ProjetMajeurEse5ETI/Hardware/Alimentation/Documents/TD-Projet-Majeure-Alimentation-36V-vers-5V-Correction.pptx

## Projet majeure – TP Alimentation

September 2024
Matisse BOFFY – Analog Field Applications Engineer
+33 6 86 36 88 47 | m-boffy@ti.com

## Specifications

Maximum Input Voltage | 36V
Nominal Input Voltage | 30V
Output Voltage | 5V
Output Current | 2.5A
Target Efficiency | 92%
Output voltage ripple | < 5%
Output voltage variation during 50% to 100% load steps | < 5%
Switching frequency | 200kHz
Maximum inductor current ripple | 30%

Specifications du projet

Bonnes pratiques

## Power Stage – P-MOS selection criteria

- Key specifications
  - Drain-source breakdown voltage V_(DS)
  - Continuous Drain Current I_D
  - Drain−source ON resistance R_(DS_(on))
  - Total gate charge Q_G
  - Output capacitance C_(oss)
- Losses : Conduction, switching & gate drive
  - P_(cond) =I_(RMS) ^2 ×R_(DS_(on))
  - P_(sw) =(F_(sw))/2(V_(IN) ×I_(pk) ×t_(swON) )+(F_(sw))/2(V_(IN) ×I_(pk) ×t_(swOFF) )
  - P_(Gdrive) =V_G ×F_(SW) ×Q_G

Notes: Output cap Coss effect

## Power Stage – P-MOS selection

- OnSemi FDC5614P
- Key specifications
  - Drain−source ON resistance R_(DS_(on)) : 105 mΩ (@V_(GS) =−10V)
  - Drain-source breakdown voltage V_(DS) : -60V
  - Continuous Drain Current I_D : -3A @25°C
  - Total gate charge Q_G : 24 nC
  - Output capacitance C_(oss) : 90 pF
- Losses : Conduction, switching & gate drive
  - P_(cond) =I_(RMS) ^2 ×R_(DS_(on)) =(1/(√2))^2 ×0.078= 0.8 mW
  - P_(sw) =(F_(sw))/2(V_(IN) ×I_(pk) ×t_(swON) )+(F_(sw))/2(V_(IN) ×I_(pk) ×t_(swOFF) ) = 220 mW
  - P_(Gdrive) =V_G ×F_(SW) ×Q_G = 7.6 mW
  - Total Power losses P_(totMOS) =228.4 mW

Notes: Output cap Coss effect

## Power Stage – Inductor selection criteria

- Key specifications
  - Inductance value
  - Saturation current 10% I_(SAT)
  - RMS current I_(RMS) (20, 40°C)
  - Equivalent Series Resistor ESR
- Losses : Conduction, core & windings
  - P_(cond) =I_(LRMS) ^2 ×ESR
  - Cores & windings losses are specified in manufacturer’s datasheet

Notes: Output cap Coss effect

## Power Stage – Inductor selection

- Coiltronics DR127-330
- Key specifications
  - Inductance value with 30% current ripple at 30Vin:
L=(V_(out) ×(V_(in) −V_(out) ))/(∆I_L ×f_(SW) ×V_(IN))=(5×(30−5))/(0.3×2.5×200×10^3 ×30)=27uH
  - Equivalent Series Resistor ESR : 60 mΩ
  - RMS current I_(RMS) (20, 40°C) : 3.23 A
- Losses : Conduction, core & windings
  - P_(cond) =I_(LRMS) ^2 ×ESR = √(I_(PK)^2 +(∆I^2)/12)^2 ×ESR=96 mW
  - Cores & windings losses : 3 mW
  - Total Power losses P_(totL) =99 mW

Notes: Output cap Coss effect

## Power Stage – Rectifier selection criteria

- Key specifications
  - Breakdown voltage V_R
  - Continuous forward current I_F
  - Forward voltage V_F
  - Diode capacitance Ct
- Losses : Conduction & AC
  - P_(cond) =V_F ×(I_(out) +(∆I)/4)×D_(utyCycle)
  - P_(AC) =1/2(C_t ×(V_(IN) +V_f )^2 ×f)

Notes: Output cap Coss effect

## Power Stage – Rectifier selection

- OnSemi MBRS360
- Key specifications
  - Breakdown voltage V_R : 60V
  - Forward voltage V_F : 0.6V
  - Continuous forward current I_F : 3A
  - Diode capacitance Ct : 60 pF @30Vr
- Losses : Conduction
  - P_(cond) =V_F ×(I_(out) +(∆I)/4)×D_(utyCycle)
  - P_(AC) =1/2(C_t ×(V_(IN) +V_f )^2 ×f)

Notes: Output cap Coss effect

## Power Stage – output capacitor selection criteria

- Key specifications
  - Capacitance (F)
  - Voltage rating (V)
  - ESR
- Losses : Conduction
  - P_(cond) =I_(incap) ^2 ×ESR

Notes: Output cap Coss effect

## Power Stage – output capacitor selection criteria

- Panasonic EEVFK0J221P
- Key specifications
  - Capacitance
C_(out) =(∆I_(Transient))/(2πf_(loopBW) ∆V_(Transient))=(0.5×2.5)/(2π×22k×0.05×5)=36 uF , this is the effective capacitance
  - ESR : 160 mΩ
  - Voltage rating 6.3V
- Losses : Conduction
  - P_(cond) =I_(incap) ^2 ×ESR

Can also be used

Notes: Output cap Coss effect

## Power Stage – input capacitor selection criteria

- Key specifications
  - Capacitance (F)
  - Voltage rating (V)
  - ESR
- Losses : Conduction
  - P_(cond) =I_(incap) ^2 ×ESR

Notes: Output cap Coss effect

## Power Stage – input capacitor selection

- Panasonic EEUFC1J101
- Key specifications
  - Capacitance
C_(in) ≥(D(1−D)∗I_(out))/(∆V_(in_(pp)) ∗f_(sw))≥1.15uF
  - Voltage rating : 50V
- Losses : Conduction
  - P_(cond) =I_(incap) ^2 ×ESR

Notes: Output cap Coss effect

## Additional passives

- Current limit resistor
R_(ILIM) =0.1/((I_(PK) +(∆I)/2)×1.25)=33mΩ
- Soft Start Cap C_(SS)
  - tss≥2π×√(L_(out) ×C_(out)) ≥2.4ms
  - C_(SS) =(tss)/(R_C ×ln((V_(SST))/(V_(SST) −1.4)))=(10ms)/(105k×ln(8/(8−1.4)))=0.47u
- Gain setting resistor
- V_(OUT) =0.696×(1+(R_2)/(R_1))=5V
- R_2 is fixed by the type III loop compensation, R_2 =4.8kΩ ► R_2 =626Ω
- Frequency setting R&C
- F_(SW) =1/(R_(RC) ×C_(RC) ×0.105)=200k ► R_(RC) =100kΩ & C_(RC) =470pF

Notes: Output cap Coss effect
