ProjetMajeurEse5ETI/Hardware/Pont en H/Simulation/Pont en H - Driver - Plots.png

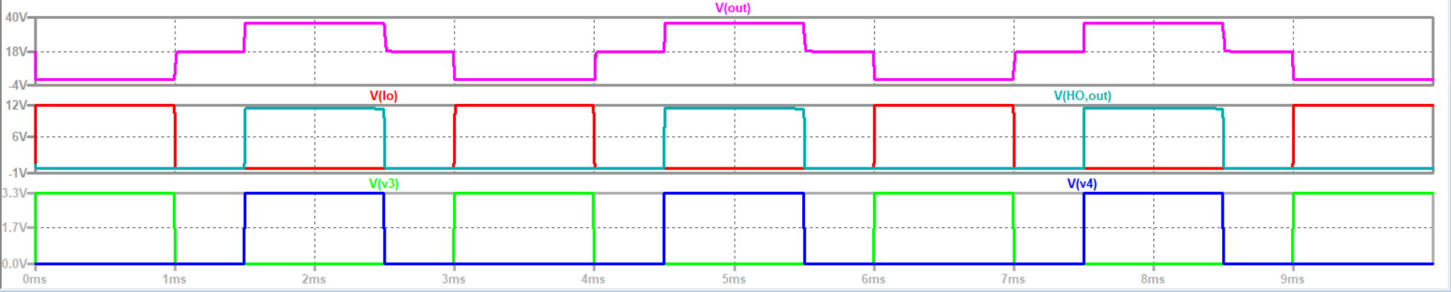
Pont en H/Simulation/Pont en H - Driver - Plots.png
