ProjetMajeurEse5ETI/Hardware/Pont en H/Simulation/Pont en H - Driver.asc

C1: cap; 1µ
C2: cap; 100n
D1: diode; 1N914
D2: schottky; 1N5819
D3: schottky; 1N5819
M3: nmos; BSB012N03LX3
M4: nmos; BSB012N03LX3
R1: res; 10
R2: res; 10
R3: res; 1k
R4: res; 1k
R5: res; 10
R6: res; 10
R7: res; 1Meg
R8: res; 1Meg
U1: IR2101
V1: voltage; 36
V2: voltage; 12
V3: voltage; PULSE(0 3.3 0 0.1n 0.1n 1m 3m)
V4: voltage; PULSE(0 3.3 1.5m 0.1n 0.1n 1m 3m)
Named nets: 0, VCC, VC2, out, LO, HO, V4, V3
.tran 0 10m 0
