ProjetMajeurEse5ETI/Hardware/Alimentation/Test/Alim_DC-DC_30-5V_Efficacité.xlsx

Vin | Vout | Input Current | Output current | Efficiency
10 | 5 | 0.264 | 0.473 | 0.8958333333
10 | 5 | 0.362 | 0.665 | 0.9185082873
10 | 5 | 0.4 | 0.733 | 0.91625
10 | 5 | 0.436 | 0.796 | 0.9128440367
10 | 5 | 0.455 | 0.83 | 0.9120879121
20 | 5 | 0.127 | 0.458 | 0.9015748031
20 | 5 | 0.175 | 0.631 | 0.9014285714
20 | 5 | 0.202 | 0.712 | 0.8811881188
20 | 5 | 0.295 | 1.025 | 0.8686440678
20 | 5 | 0.406 | 1.414 | 0.8706896552
30 | 5 | 0.087 | 0.464 | 0.8888888889
30 | 5 | 0.109 | 0.585 | 0.8944954128
30 | 5 | 0.141 | 0.761 | 0.8995271868
30 | 5 | 0.188 | 0.975 | 0.8643617021
30 | 5 | 0.22 | 1.162 | 0.8803030303
