ProjetMajeurEse5ETI/Hardware/(commit log)

2024-09-26 Add functionnal simulation file + plots for the driver for the brushless motor.
2024-09-30 Ajout alimentation rapport de tests et dimmensionnement DC-DC 30V to 5V
    [Alim_DC-DC_30-5V_Efficacité.xlsx]
2024-10-08 Ajout de la doc pour le buck et rapport de test pour buck 36V à 5V
